sagrado26/Bike-Computer-/Full Schematic.PNG

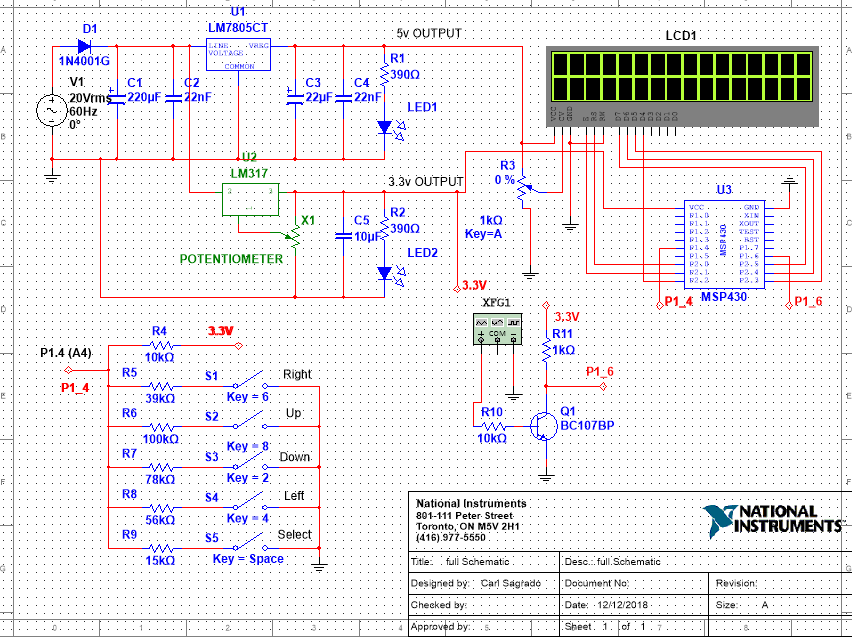
Full Schematic.PNG
